RongmingGuo/ME4012_FinalProject/Deliverables/CartPicture.jpg

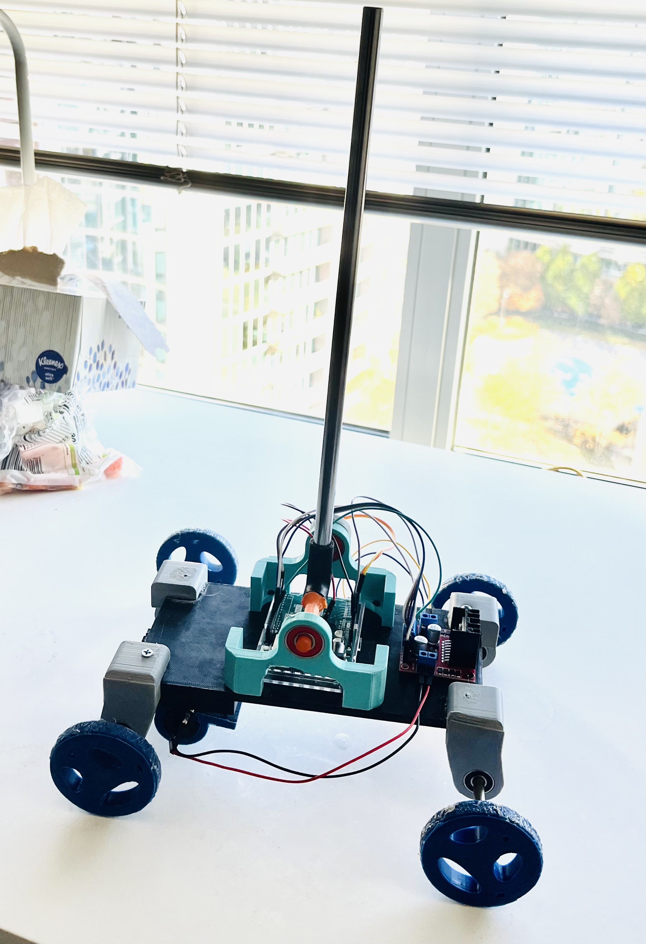
Deliverables/CartPicture.jpg
