RongmingGuo/ME4012_FinalProject/Theory/ME4012_FinalProject_Theory.docx

ME 4012 Final Project Theory Formulation

SECTION A. System Dynamics Modelling

Part 1. Cart Dynamics ( (Θ(s))/(Τ(s)) )

[Schematic]

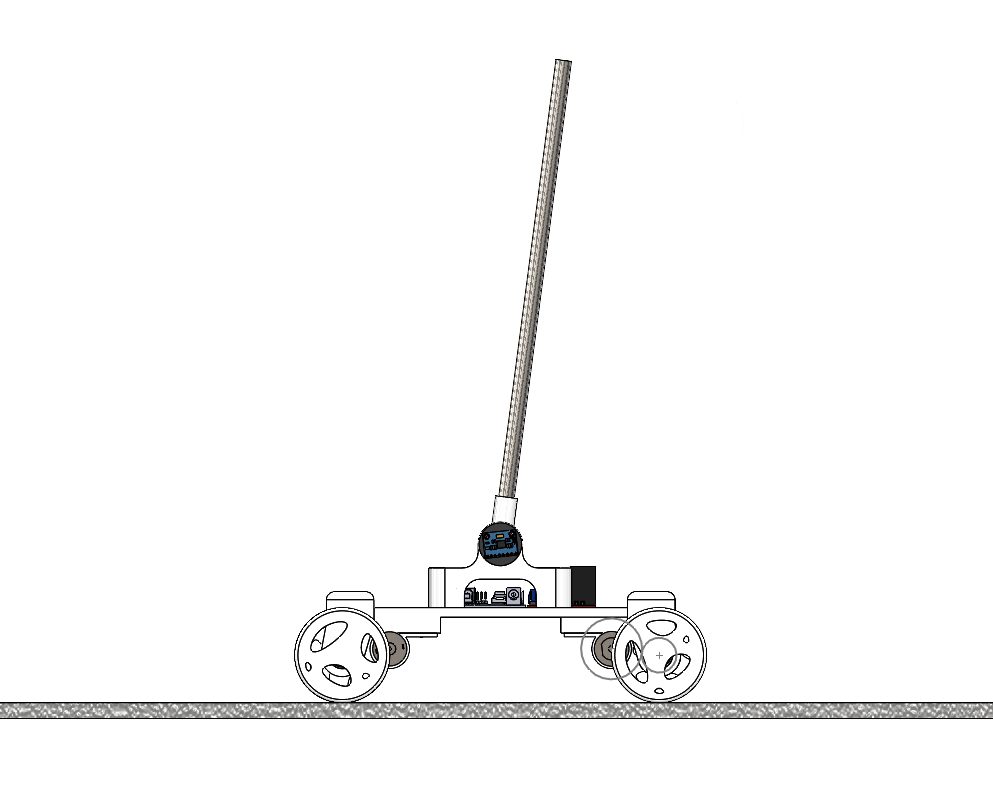
[picture p2: figure]

φ

+θ

+y

+x

τ

τ

θ

[Known]

1. World frame definition. Note that clockwise, rather than counterclockwise, is defined as the positive direction for angular quantities.
2. All relevant geometric & inertial quantities of the cart:

[Find]

The transfer function (Θ(s))/(Τ(s)) from wheel torque τ to the angular displacement of the inverted pendulum from its equilibrium position θ .

[Assumptions]

1. The cart body, excluding the pendulum, is perfectly symmetrical front-to-back and left-to-right.
2. The input torques at four wheels are of identical value at all times.
3. The torque will never break the traction of the tire (non-slip condition at the wheels).

[Analysis]

Free Body Diagram of the Cart Body (Excluding the Pendulum) in the x direction:

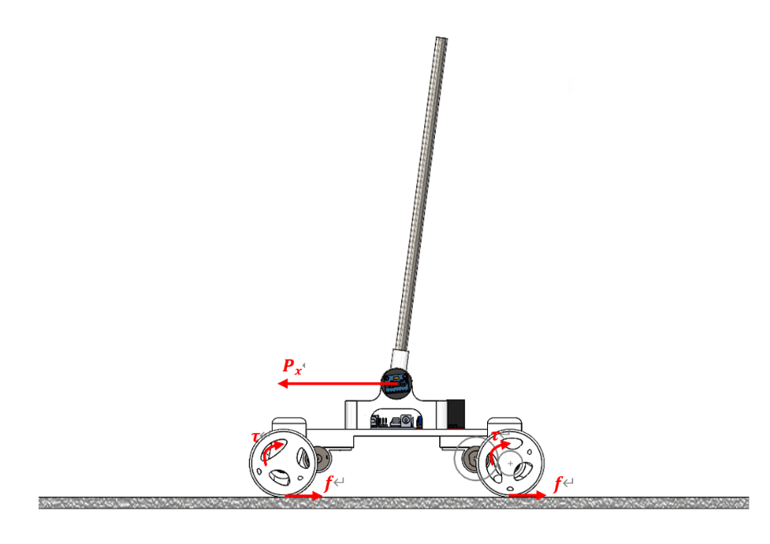
[picture p3: figure]

Dynamics at the wheel:

I_w φ= τ-fR…(1)

Dynamics of the cart body:

Mx=4f-P_x …(2)

Kinematics Constraint:

x=Rφ…(3)

Free Body Diagram of the Pendulum:

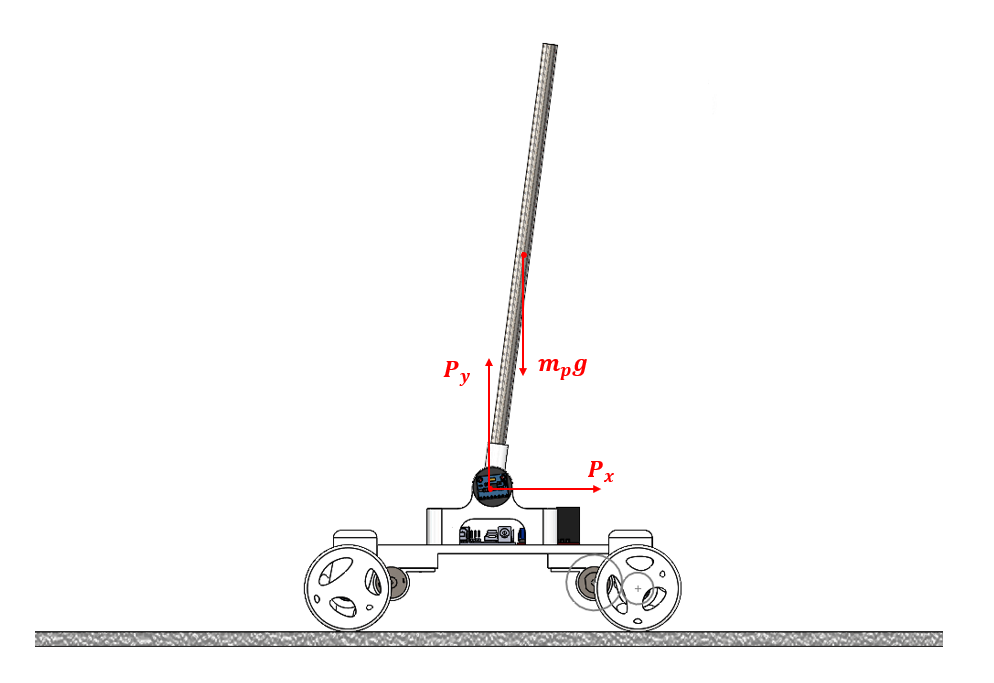
[picture p4: figure]

Linear Dynamics of the Pendulum:

m_p x_p =P_x …(4)

m_p y_p = -m_p g+P_y …(5)

Angular Dynamics of the Pendulum:

I_p θ=P_y (L*sinθ))-P_x (L*cos⁡θ)…(6)

Kinematics Constraint:

x_p =x+L*sinθ…(7)

y_p =L*cosθ…(8)

Take second order derivative of equation (7) and (8) to transform kinematics relationship at displacement level to acceleration level:

x_p =x+L*cosθθ

y_p =-L*sinθθ

(First Order)

x_p =x+L*(-sinθθ^2 +cosθθ)…(9)

y_p =-L*(cosθθ^2 +sinθθ)…(10)

(Second Order)

From equation (1) and (3), we have

MRφ=4f-P_x

Multiply both sides by 1/4R :

1/4MR^2 φ=fR-1/4(RP_x )

Add the above equation with (2) to eliminate friction term:

(1/4MR^2 +I_w )φ= τ-1/4(RP_x )

From equation (3), (4) and (9), we can represent P_x using a bunch of accelerations:

P_x =m_p [Rφ+L*(-sinθθ^2 +cosθθ)]…(11)

Therefore, the first equation of motion relating input torque τ to the two kinematics variables θ and φ can be obtained

(1/4MR^2 +I_w )φ= τ-R/4[m_p [Rφ+L*(-sinθθ^2 +cosθθ)]]…EOM_1

Combine equation (5) and (10), we can represent P_y with a bunch of accelerations:

P_y =m_p (-L*(cosθθ^2 +sinθθ))+m_p g…(12)

Plug equation (11) and (12) into equation (6), we can obtain the second equation of motion relating the two kinematics variables θ and φ .

I_p θ=[m_p (-L*(cosθθ^2 +sinθθ))+m_p g](L*sinθ)-m_p [Rφ+L*(-sinθθ^2 +cosθθ)](L*cosθ)…EOM_2

Using the above two equations of motion, MATLAB is able to solve for the exact solutions of the dynamics when provided with initial conditions and control torque. The “nonlinear_simulation.m” file utilizes this approach and creates a simulation environment for testing and tuning our controllers.

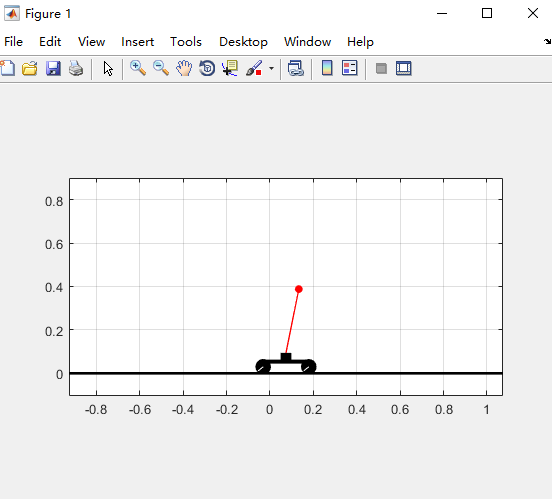
[picture p5: figure]
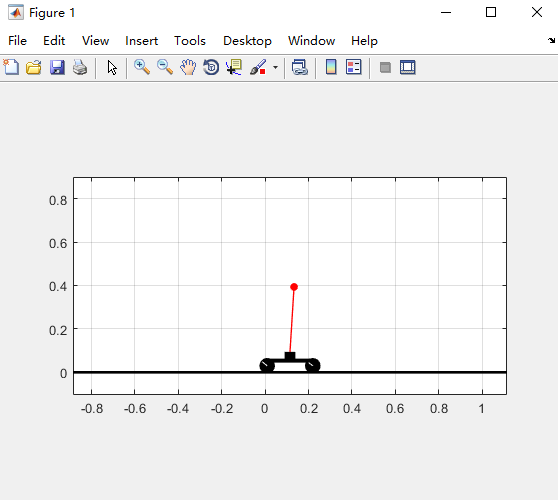
[picture p6: figure]
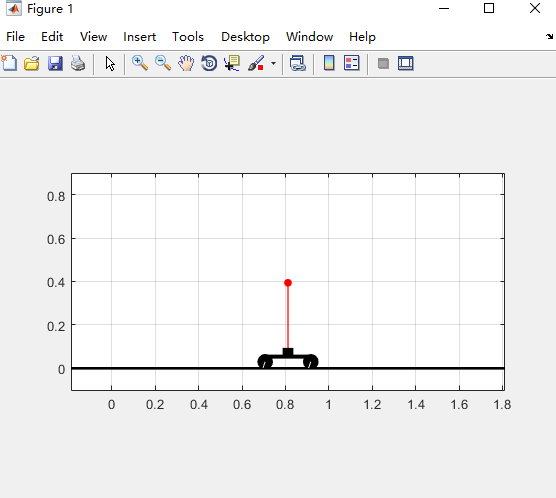
[picture p7: figure]

t = 0.03s t = 0.08s t = 0.5s

To obtain transfer function, however, the system needs to be linearized. Linearize around the operating point

θ_0 =0

Linearizing EOM1:

(1/4MR^2 +I_w )φ= τ-R/4[m_p [Rφ+L*(-sinθθ^2 +cosθθ)]]…EOM_1

First, reorganize terms:

(1/4MR^2 +I_w +(m_p R^2)/4)φ+(m_p RL)/4(-sinθθ^2 +cosθθ)= τ

Linearize using the following approximations:

sinθ≈∆θ cosθ≈1 θ^2 ≈(0)^2 +(0)(∆θ)=0

(1/4MR^2 +I_w +(m_p R^2)/4)φ+(m_p RL)/4θ= τ…Linearized EOM1

Linearize EOM2 using the same approximations:

I_p θ=[m_p (-L*(cosθθ^2 +sinθθ))+m_p g](L*sinθ)-m_p [Rφ+L*(-sinθθ^2 +cosθθ)](L*cosθ)

I_p θ=m_p g(Lθ)-m_p L(Rφ+Lθ)

Reorganize terms:

(I_p +m_p L^2 )θ-m_p gLθ=m_p LRφ…EOM2

Take Laplace transform on both linearized equations:

(1/4MR^2 +I_w +(m_p R^2)/4)s^2 Φ(s)+(m_p RL)/4s^2 Θ(s)= Τ(s)…(13)

(I_p +m_p L^2 )s^2 Θ(s)-(m_p gL)Θ(s)=(m_p LRs^2 )Φ(s)…(14)

Plug (14) back into (13) yields the ultimate transfer function (Θ(s))/(Τ(s)) :

(I_w +((M+m_p )R^2)/4)s^2 (((I_p +m_p L^2 )s^2 - (m_p gL))/((m_p LRs^2 )))Θ(s)+ (m_p RL)/4s^2 Θ(s)= Τ(s)

(Θ(s))/(Τ(s))=1/([(I_w +((M+m_p )R^2)/4)((I_p +m_p L^2)/((m_p LR))+((m_p RL)/4)]s^2 -((I_w +((M+m_p )R^2)/4)g)/R)

Overall, the system appears to be second order with zero damping, which agrees with our intuition since zero-friction condition was assumed.

Comparing the step response of the linearized system with that of the original nonlinear system:

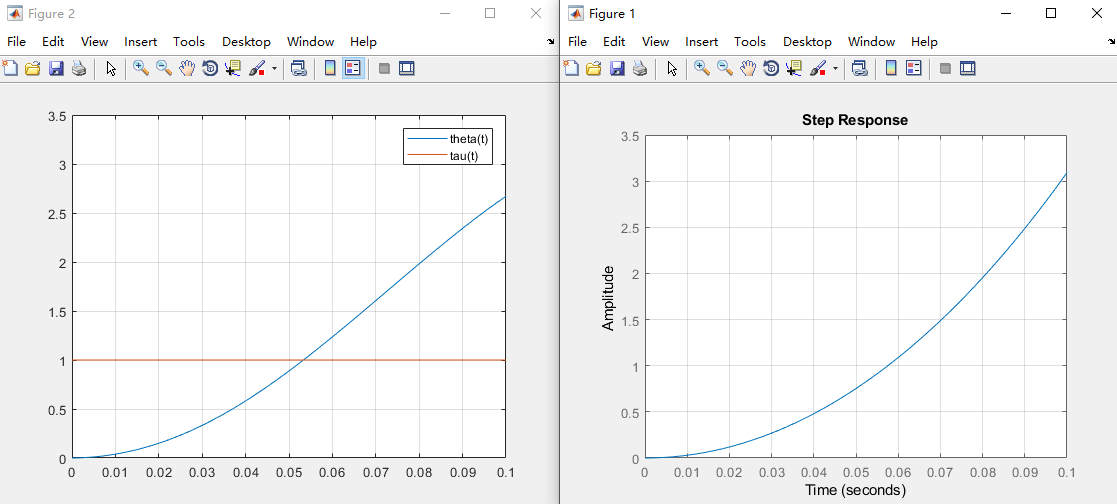
[picture p8: figure]

The result is pretty satisfactory.
