RongmingGuo/ME4012_FinalProject/References.docx

https://mschoeffler.com/2017/10/05/tutorial-how-to-use-the-gy-521-module-mpu-6050-breakout-board-with-the-arduino-uno/
