RongmingGuo/ME4012_FinalProject/ME4012_finalProject_Official_Nov2/ME4012_finalProject_Official/CAD Design/SegwayCar2.JPG

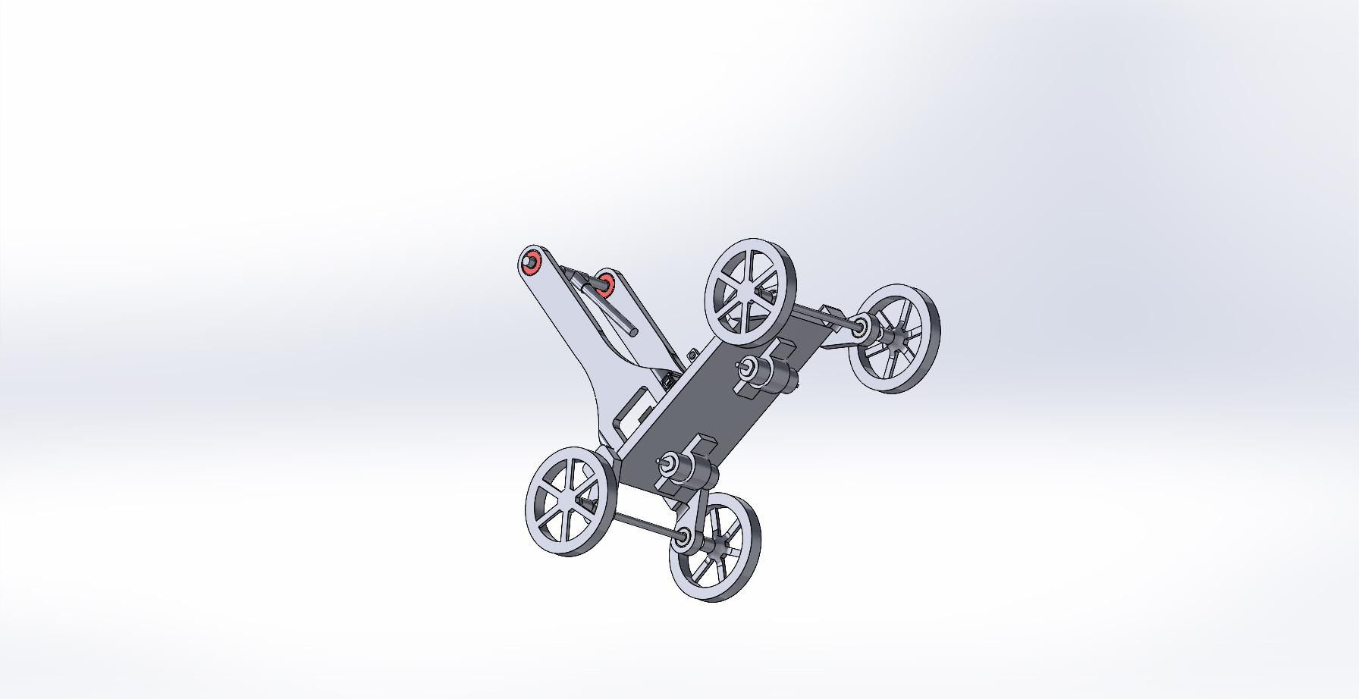
ME4012_finalProject_Official_Nov2/ME4012_finalProject_Official/CAD Design/SegwayCar2.JPG
