RongmingGuo/ME4012_FinalProject/partPurchase.xlsx

Date | Part | Website | Cost
2022-10-20 | 8mm Ball Bearings | https://www.amazon.com/gp/product/B07S1B3MS6/ref=ppx_yo_dt_b_asin_title_o00_s00?ie=UTF8&psc=1 | 17.94$
2022-10-20 | 6mm Ball Bearings | https://www.amazon.com/gp/product/B07FF6FSK7/ref=ppx_yo_dt_b_asin_title_o00_s00?ie=UTF8&psc=1
