RongmingGuo/ME4012_FinalProject/Manufacture4/mainBoard.STL

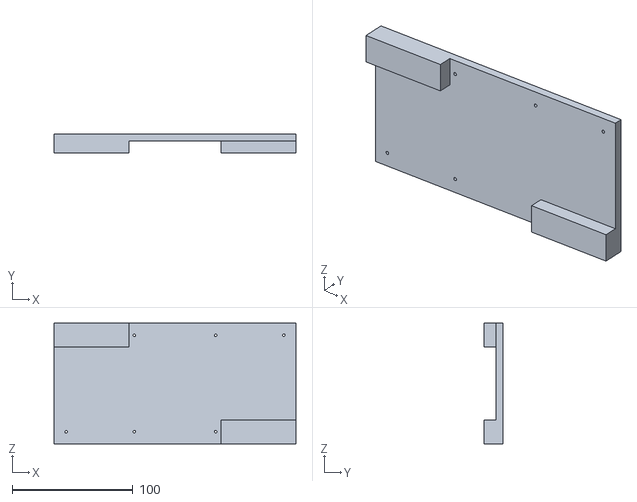
[picture p13: CAD file, 2022-11-29]
Manufacture4/mainBoard.STL
200.0 x 16.0 x 100.0
