RongmingGuo/ME4012_FinalProject/CAD_Design/CAD Design/Mechatronic Components/DC Motor.SLDPRT

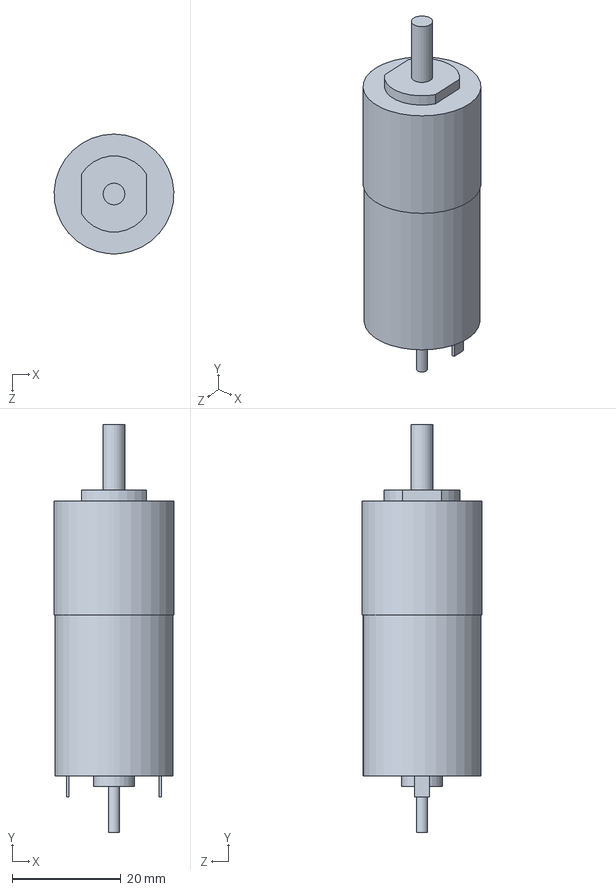
[picture p14: CAD file, 2022-10-30]
CAD_Design/CAD Design/Mechatronic Components/DC Motor.SLDPRT
22.0 x 74.9 x 22.0 mm
