RongmingGuo/ME4012_FinalProject/ME4012_finalProject_Official_Nov2/ME4012_finalProject_Official/CAD Design/CAD Design/motorMount.SLDPRT

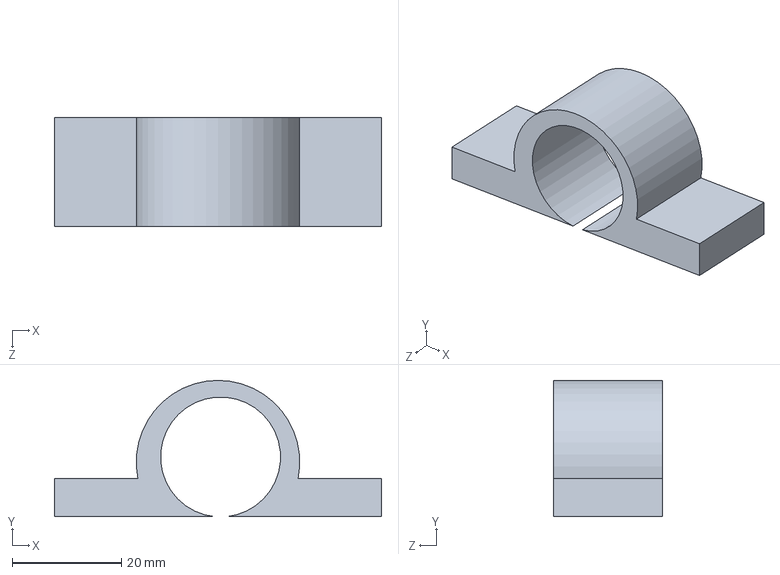
[picture p15: CAD file, 2022-10-30]
ME4012_finalProject_Official_Nov2/ME4012_finalProject_Official/CAD Design/CAD Design/motorMount.SLDPRT
60.0 x 25.0 x 20.0 mm
