RongmingGuo/ME4012_FinalProject/ME4012_finalProject_Official_Nov2/ME4012_finalProject_Official/CAD Design/Mechatronic Components/flange.SLDPRT

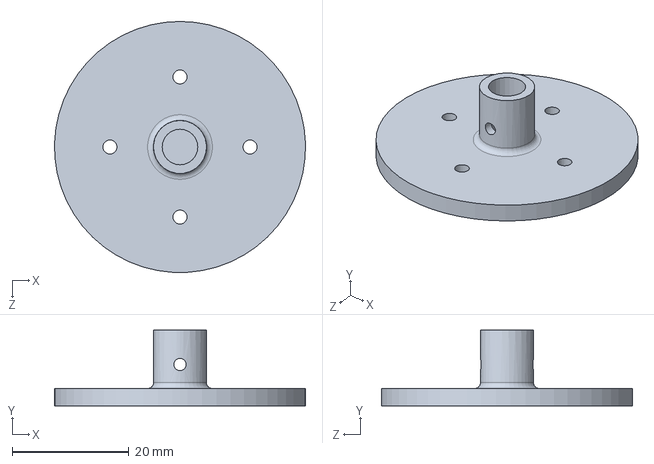
[picture p16: CAD file, 2022-11-29]
ME4012_finalProject_Official_Nov2/ME4012_finalProject_Official/CAD Design/Mechatronic Components/flange.SLDPRT
43.0 x 13.0 x 43.0 mm
