RongmingGuo/ME4012_FinalProject/ME4012_finalProject_Official_Nov2/ME4012_finalProject_Official/Manufacture1/Pole_version2.STL

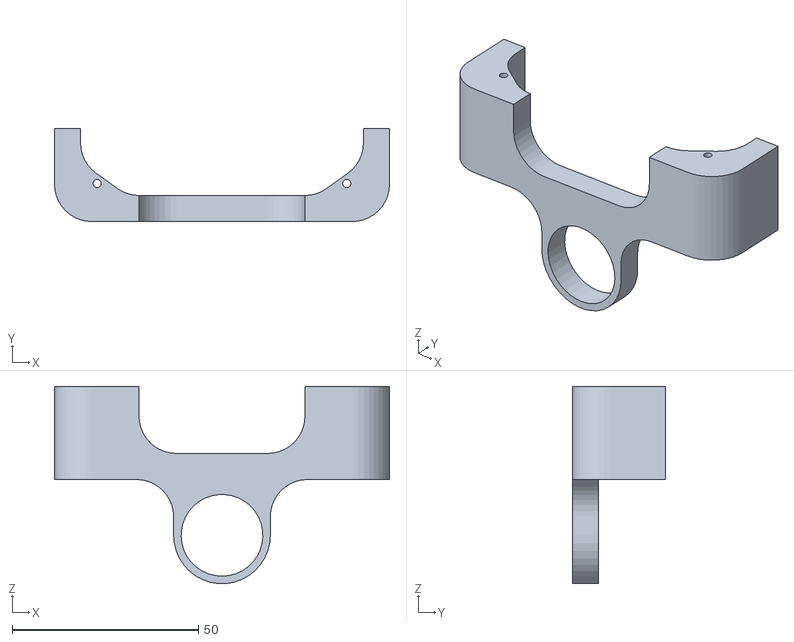
[picture p18: CAD file, 2022-10-30]
ME4012_finalProject_Official_Nov2/ME4012_finalProject_Official/Manufacture1/Pole_version2.STL
90.0 x 25.0 x 53.0
