RongmingGuo/ME4012_FinalProject/ME4012_finalProject_Official_Nov2/ME4012_finalProject_Official/Manufacture2/6mmShaft.STL

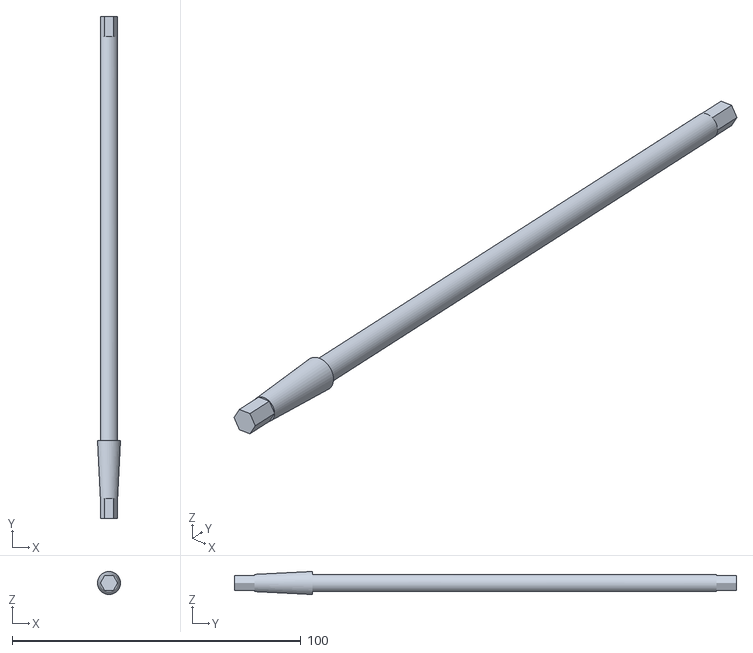
[picture p19: CAD file, 2022-11-29]
ME4012_finalProject_Official_Nov2/ME4012_finalProject_Official/Manufacture2/6mmShaft.STL
7.99 x 174.0 x 8.00
