RongmingGuo/ME4012_FinalProject/ME4012_finalProject_Official_Nov2/ME4012_finalProject_Official/Manufacture3/centralShaftsecurer.STL

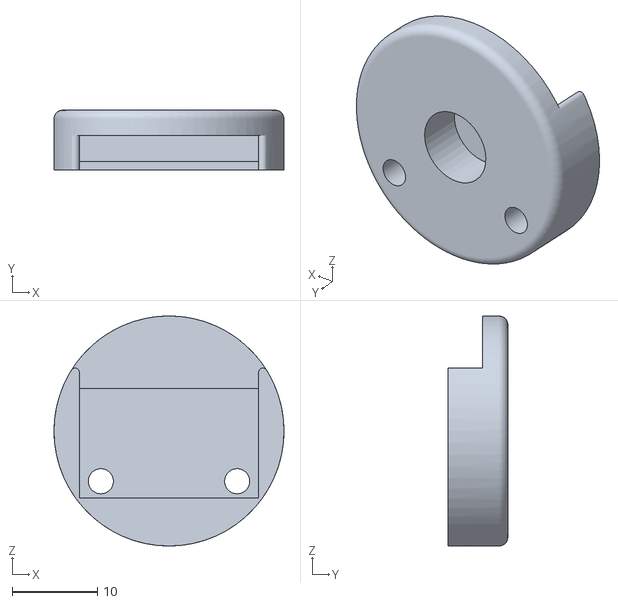
[picture p20: CAD file, 2022-11-29]
ME4012_finalProject_Official_Nov2/ME4012_finalProject_Official/Manufacture3/centralShaftsecurer.STL
27.0 x 7.00 x 27.0
