RongmingGuo/ME4012_FinalProject/ME4012_finalProject_Official_Nov2/ME4012_finalProject_Official/Manufacture4/flange.STL

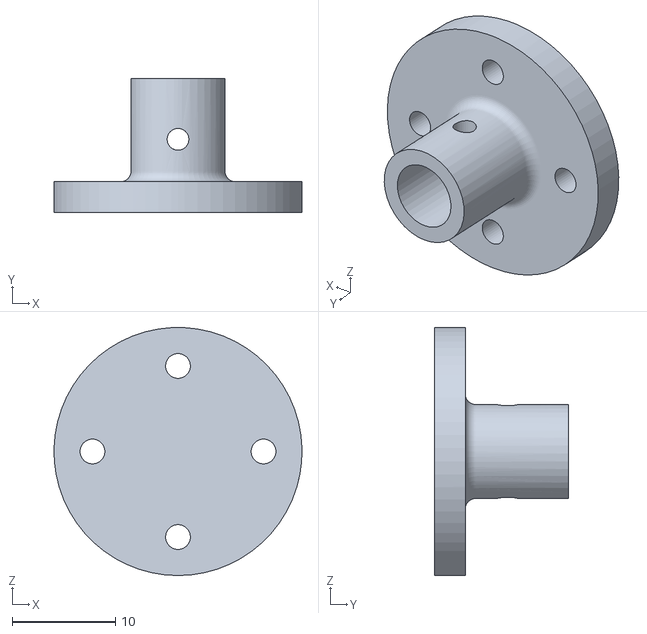
[picture p21: CAD file, 2022-11-29]
ME4012_finalProject_Official_Nov2/ME4012_finalProject_Official/Manufacture4/flange.STL
24.0 x 13.0 x 24.0
