RongmingGuo/ME4012_FinalProject/Manufacture4/BIG_GEAR2.SLDPRT

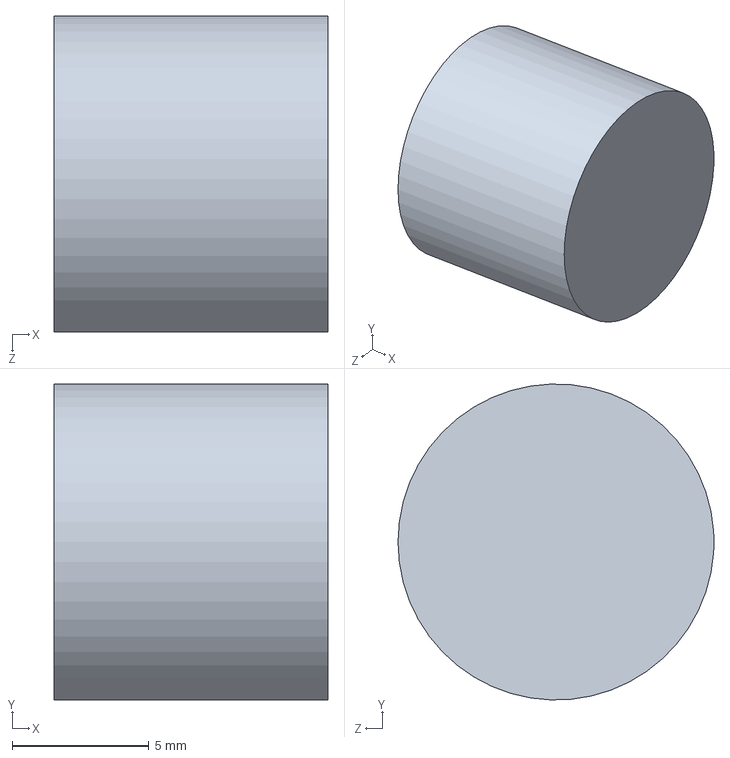
[picture p22: CAD file, 2022-11-29]
Manufacture4/BIG_GEAR2.SLDPRT
10.0 x 11.5 x 11.5 mm
