RongmingGuo/ME4012_FinalProject/ME4012_finalProject_Official_Nov2/ME4012_finalProject_Official/CAD Design/CAD Design/Mechatronic Components/MPU_6050.SLDPRT

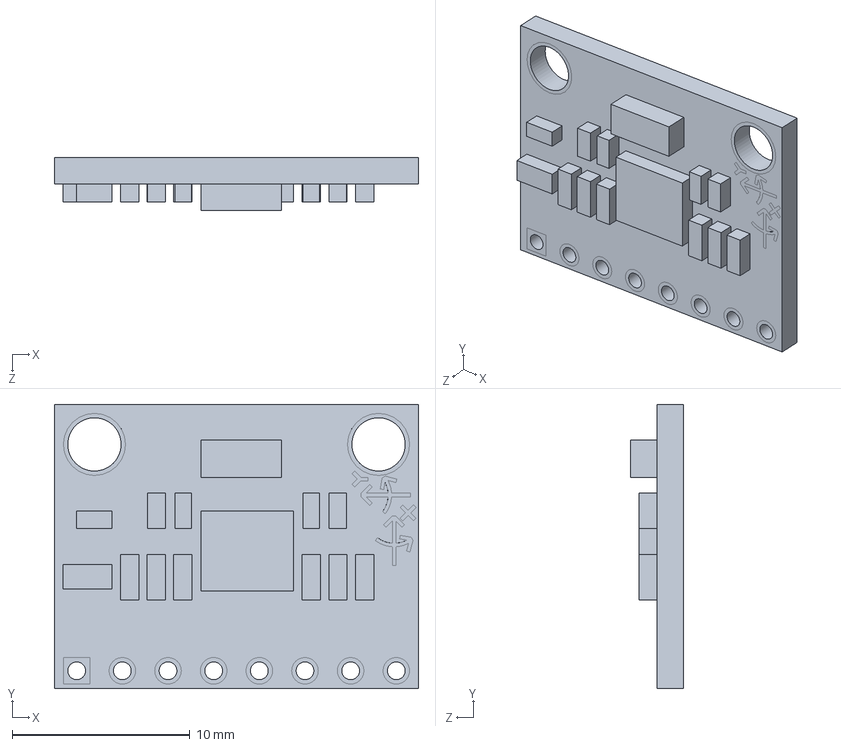
[picture p23: CAD file, 2022-10-30]
ME4012_finalProject_Official_Nov2/ME4012_finalProject_Official/CAD Design/CAD Design/Mechatronic Components/MPU_6050.SLDPRT
20.5 x 16.0 x 3.00 mm
