RongmingGuo/ME4012_FinalProject/ME4012_finalProject_Official_Nov2/ME4012_finalProject_Official/CAD Design/Mechatronic Components/DC Motor.SLDPRT

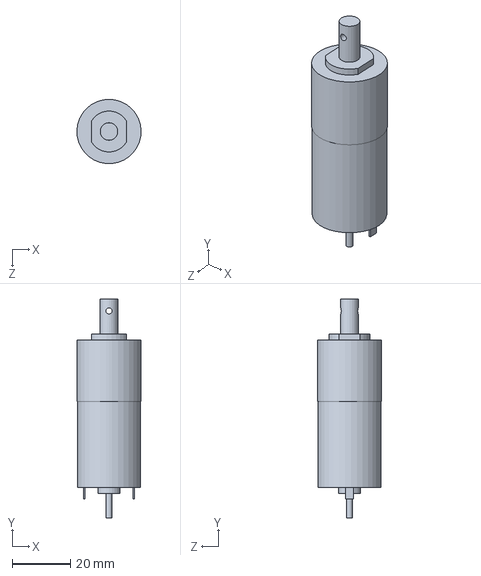
[picture p24: CAD file, 2022-11-29]
ME4012_finalProject_Official_Nov2/ME4012_finalProject_Official/CAD Design/Mechatronic Components/DC Motor.SLDPRT
22.0 x 74.9 x 22.0 mm
