RongmingGuo/ME4012_FinalProject/ME4012_finalProject_Official_Nov2/ME4012_finalProject_Official/CAD Design/Pole_version2.SLDPRT

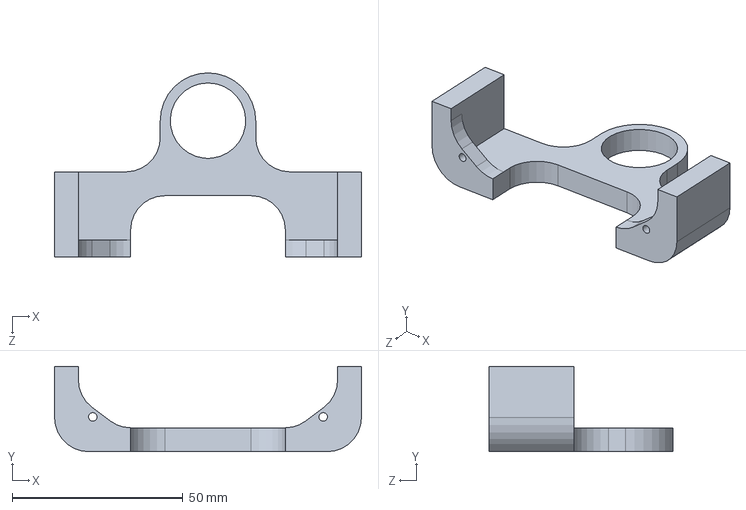
[picture p25: CAD file, 2022-11-29]
ME4012_finalProject_Official_Nov2/ME4012_finalProject_Official/CAD Design/Pole_version2.SLDPRT
90.0 x 25.0 x 54.0 mm
