RongmingGuo/ME4012_FinalProject/ME4012_finalProject_Official_Nov2/ME4012_finalProject_Official/Manufacture1/connector.STL

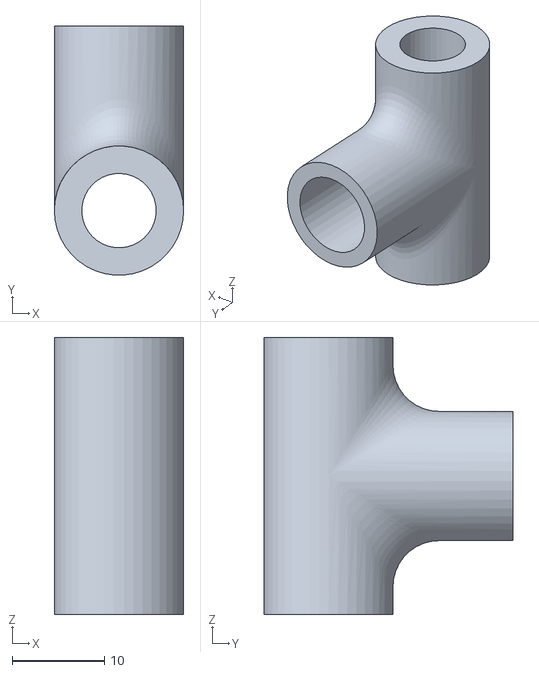
[picture p26: CAD file, 2022-10-30]
ME4012_finalProject_Official_Nov2/ME4012_finalProject_Official/Manufacture1/connector.STL
14.0 x 27.0 x 30.0
