RongmingGuo/ME4012_FinalProject/ME4012_finalProject_Official_Nov2/ME4012_finalProject_Official/Manufacture2/wheelAttacher.STL

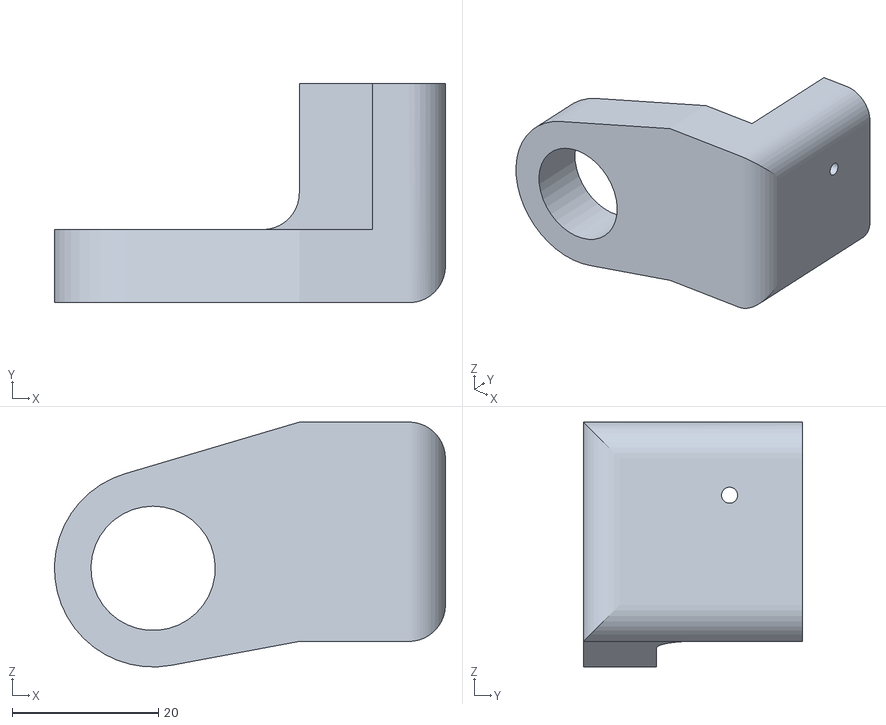
[picture p27: CAD file, 2022-11-29]
ME4012_finalProject_Official_Nov2/ME4012_finalProject_Official/Manufacture2/wheelAttacher.STL
53.5 x 30.0 x 33.5
