RongmingGuo/ME4012_FinalProject/Manufacture4/SMALL_GEAR.STL

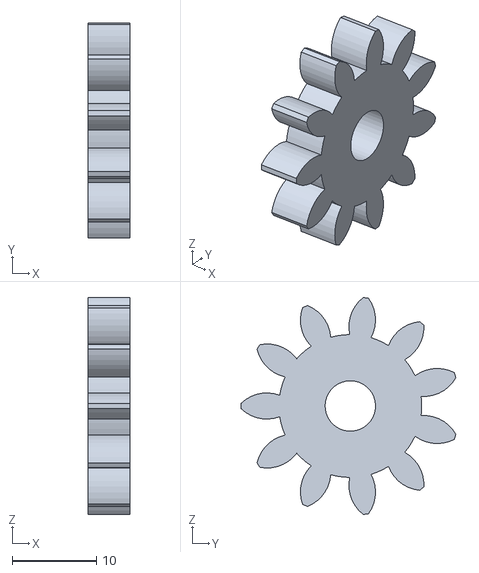
[picture p28: CAD file, 2022-11-29]
Manufacture4/SMALL_GEAR.STL
5.00 x 25.6 x 25.8
