RongmingGuo/ME4012_FinalProject/ME4012_finalProject_Official_Nov2/ME4012_finalProject_Official/CAD Design/Mechatronic Components/BallBearing.SLDPRT

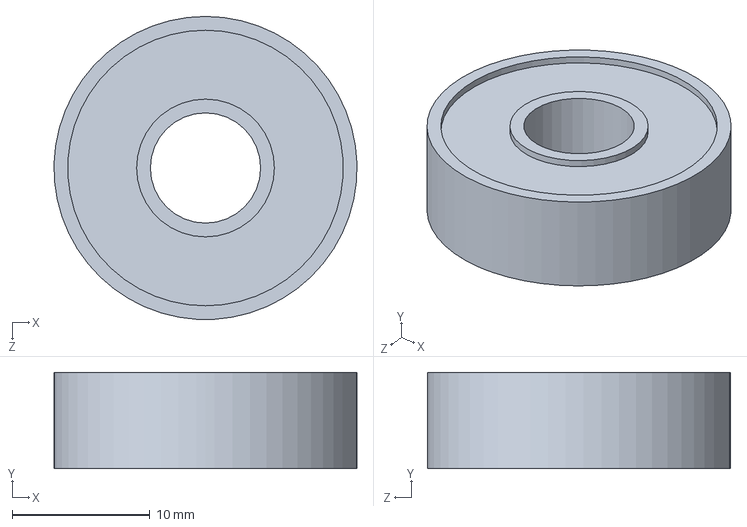
[picture p29: CAD file, 2022-10-30]
ME4012_finalProject_Official_Nov2/ME4012_finalProject_Official/CAD Design/Mechatronic Components/BallBearing.SLDPRT
22.0 x 7.00 x 22.0 mm
