RongmingGuo/ME4012_FinalProject/ME4012_finalProject_Official_Nov2/ME4012_finalProject_Official/CAD Design/motorMount.SLDPRT

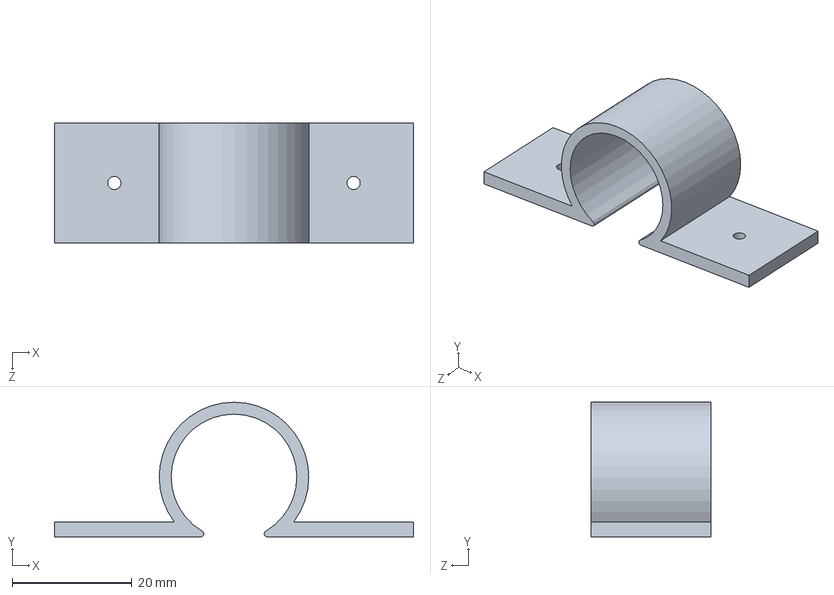
[picture p30: CAD file, 2022-11-29]
ME4012_finalProject_Official_Nov2/ME4012_finalProject_Official/CAD Design/motorMount.SLDPRT
60.0 x 22.5 x 20.0 mm
