RongmingGuo/ME4012_FinalProject/ME4012_finalProject_Official_Nov2/ME4012_finalProject_Official/Manufacture1/motorMount.STL

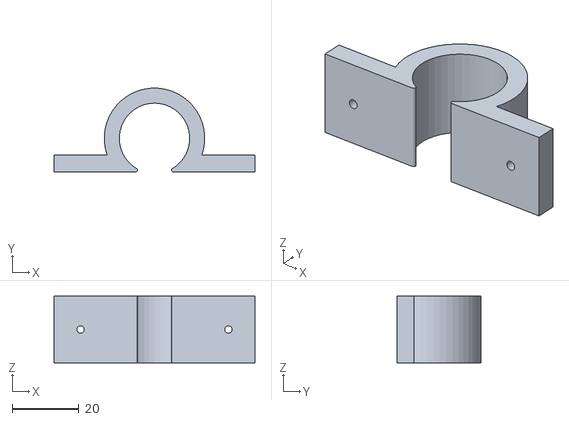
[picture p31: CAD file, 2022-10-30]
ME4012_finalProject_Official_Nov2/ME4012_finalProject_Official/Manufacture1/motorMount.STL
60.0 x 25.0 x 20.0
