RongmingGuo/ME4012_FinalProject/ME4012_finalProject_Official_Nov2/ME4012_finalProject_Official/CAD Design/Mechatronic Components/L298N Motor Driver.SLDPRT

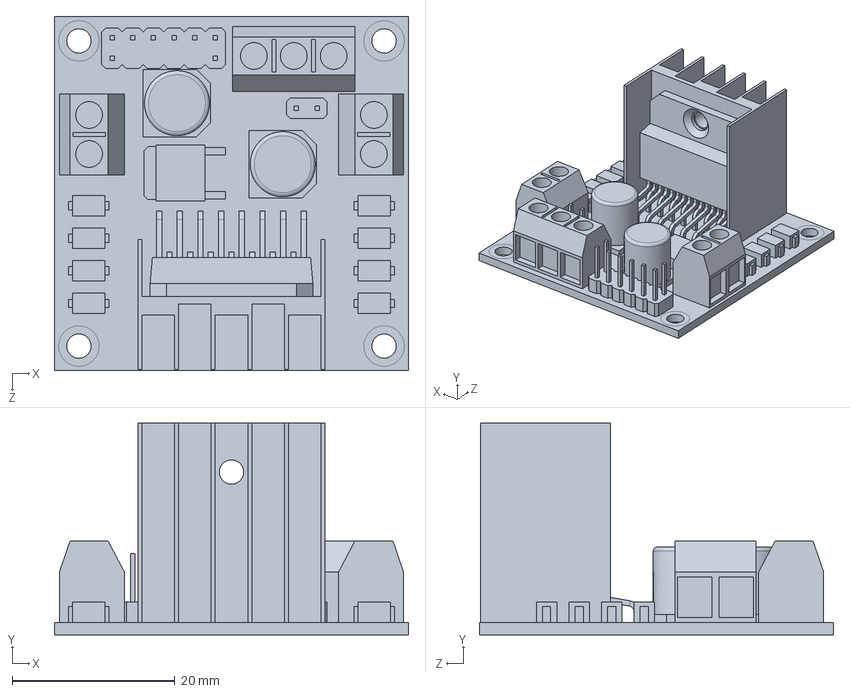
[picture p32: CAD file, 2022-10-30]
ME4012_finalProject_Official_Nov2/ME4012_finalProject_Official/CAD Design/Mechatronic Components/L298N Motor Driver.SLDPRT
43.5 x 26.0 x 43.5 mm
