RongmingGuo/ME4012_FinalProject/ME4012_finalProject_Official_Nov2/ME4012_finalProject_Official/Manufacture1/pendulumshaft.STL

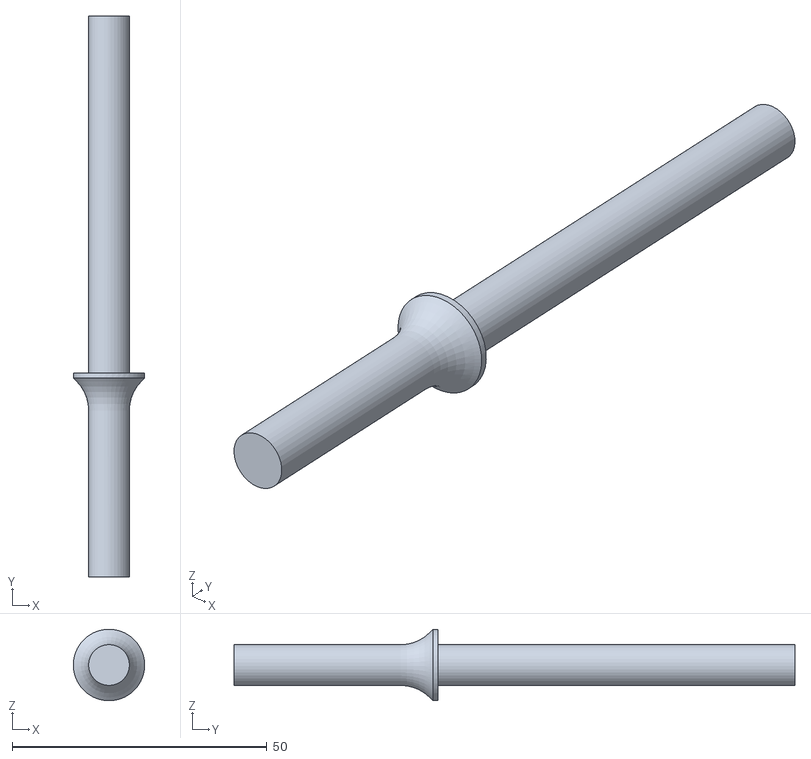
[picture p33: CAD file, 2022-10-30]
ME4012_finalProject_Official_Nov2/ME4012_finalProject_Official/Manufacture1/pendulumshaft.STL
14.0 x 110.0 x 14.0
