RongmingGuo/ME4012_FinalProject/ME4012_finalProject_Official_Nov2/ME4012_finalProject_Official/Manufacture1/centralShaftsecurer.STL

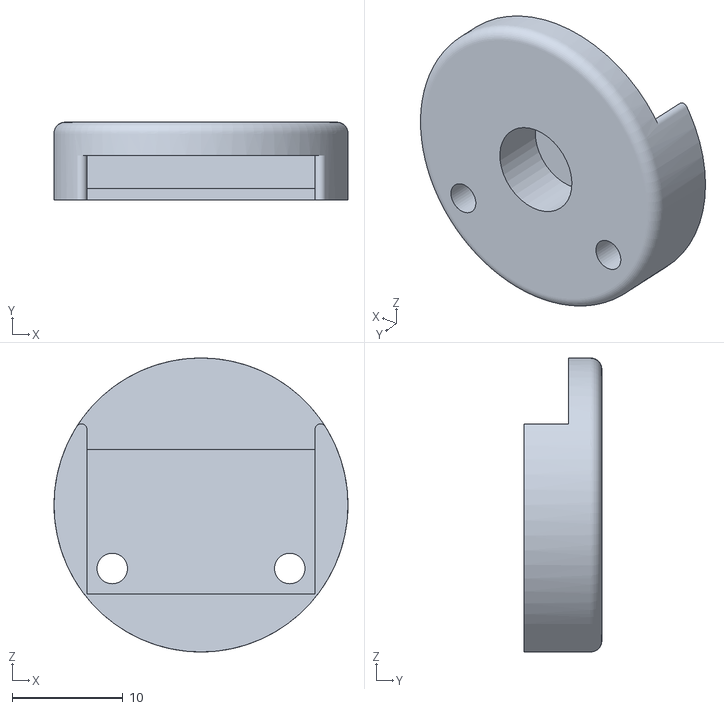
[picture p35: CAD file, 2022-10-30]
ME4012_finalProject_Official_Nov2/ME4012_finalProject_Official/Manufacture1/centralShaftsecurer.STL
26.5 x 7.00 x 26.5
