RongmingGuo/ME4012_FinalProject/ME4012_finalProject_Official_Nov2/ME4012_finalProject_Official/CAD Design/BIG_GEAR.SLDPRT

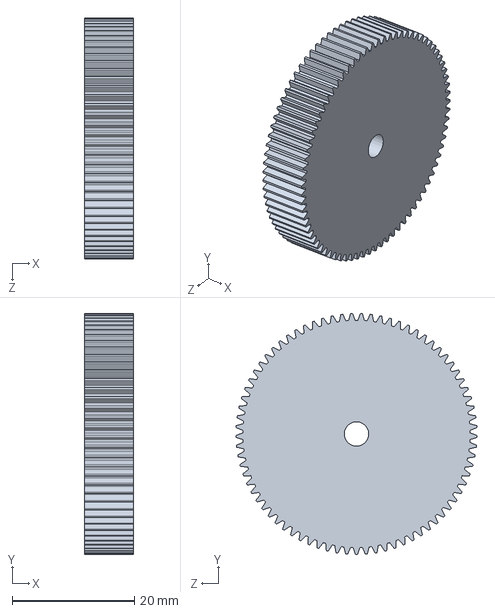
[picture p37: CAD file, 2022-11-29]
ME4012_finalProject_Official_Nov2/ME4012_finalProject_Official/CAD Design/BIG_GEAR.SLDPRT
8.00 x 39.5 x 39.5 mm
