RongmingGuo/ME4012_FinalProject/ME4012_finalProject_Official_Nov2/ME4012_finalProject_Official/Manufacture3/6mmShaft.STL

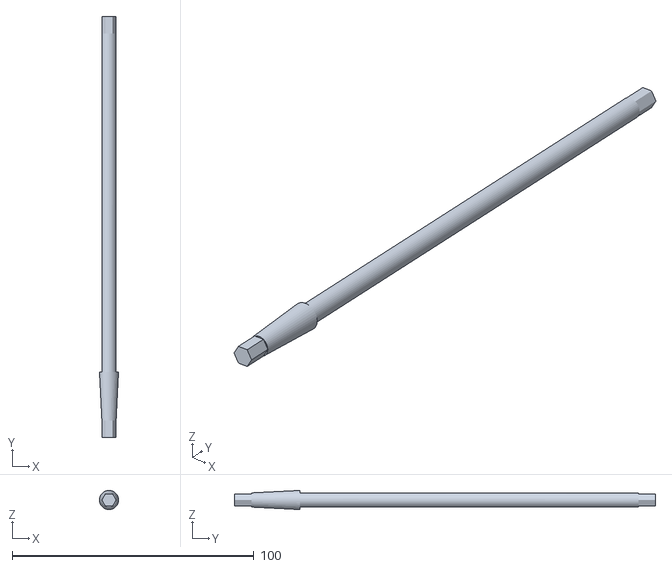
[picture p38: CAD file, 2022-11-29]
ME4012_finalProject_Official_Nov2/ME4012_finalProject_Official/Manufacture3/6mmShaft.STL
7.89 x 174.0 x 7.90
