RongmingGuo/ME4012_FinalProject/ME4012_finalProject_Official_Nov2/ME4012_finalProject_Official/CAD Design/SMALL_GEAR.SLDPRT

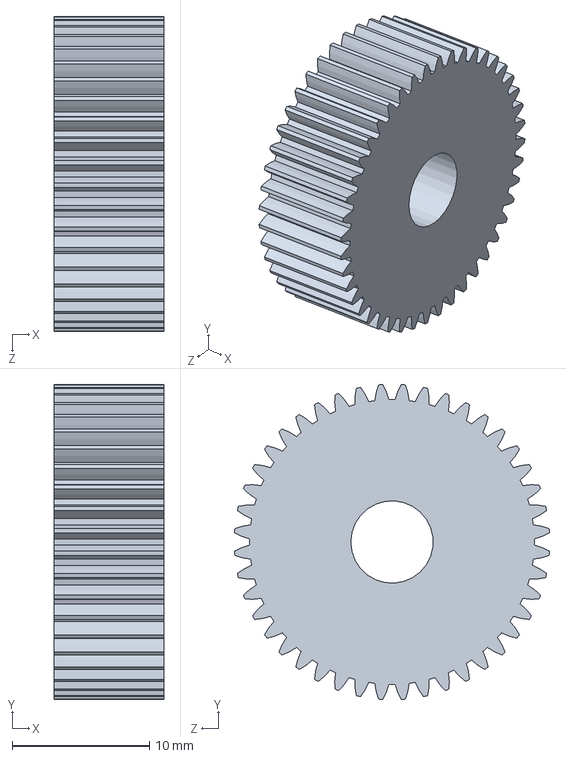
[picture p39: CAD file, 2022-11-29]
ME4012_finalProject_Official_Nov2/ME4012_finalProject_Official/CAD Design/SMALL_GEAR.SLDPRT
8.00 x 23.0 x 23.0 mm
