RongmingGuo/ME4012_FinalProject/ME4012_finalProject_Official_Nov2/ME4012_finalProject_Official/CAD Design/pendulumRod.SLDPRT

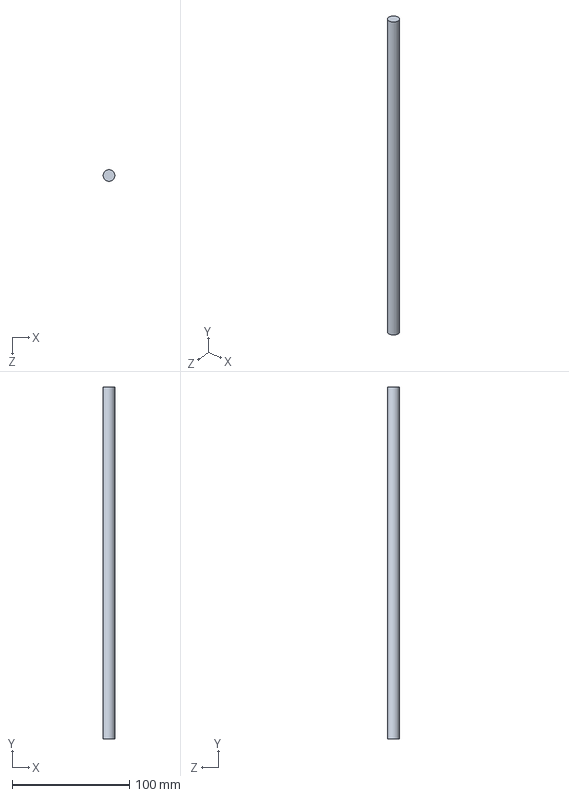
[picture p41: CAD file, 2022-10-30]
ME4012_finalProject_Official_Nov2/ME4012_finalProject_Official/CAD Design/pendulumRod.SLDPRT
10.0 x 300.0 x 10.0 mm
