RongmingGuo/ME4012_FinalProject/ME4012_finalProject_Official_Nov2/ME4012_finalProject_Official/CAD Design/pendulum.SLDPRT

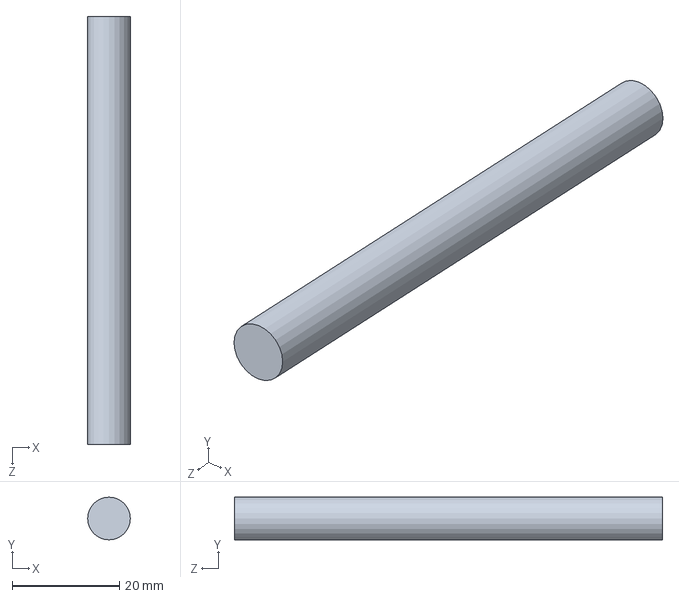
[picture p42: CAD file, 2022-10-30]
ME4012_finalProject_Official_Nov2/ME4012_finalProject_Official/CAD Design/pendulum.SLDPRT
8.00 x 8.00 x 80.0 mm
