RongmingGuo/ME4012_FinalProject/ME4012_finalProject_Official_Nov2/ME4012_finalProject_Official/CAD Design/BallBearing6mm.SLDPRT

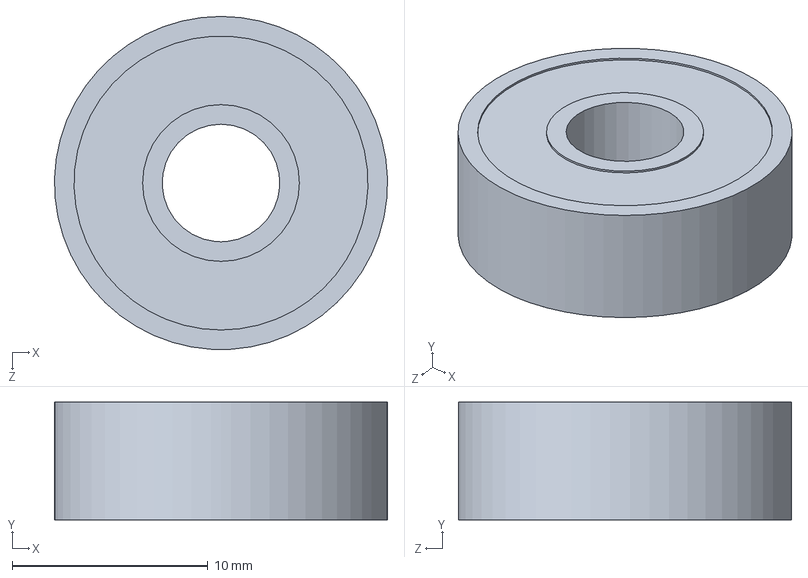
[picture p43: CAD file, 2022-10-30]
ME4012_finalProject_Official_Nov2/ME4012_finalProject_Official/CAD Design/BallBearing6mm.SLDPRT
17.0 x 6.00 x 17.0 mm
