RongmingGuo/ME4012_FinalProject/(list of files, cad)

Other CAD files:
ME4012_finalProject_Official_Nov2/ME4012_finalProject_Official/CAD Design/mainBoard.SLDPRT
ME4012_finalProject_Official_Nov2/ME4012_finalProject_Official/Manufacture3/mainBoard.STL
ME4012_finalProject_Official_Nov2/ME4012_finalProject_Official/CAD Design/CAD Design/Mechatronic Components/DC Motor.SLDPRT
ME4012_finalProject_Official_Nov2/ME4012_finalProject_Official/Manufacture3/Pole_version2.STL
ME4012_finalProject_Official_Nov2/ME4012_finalProject_Official/Manufacture2/wheelAttacher2.STL
ME4012_finalProject_Official_Nov2/ME4012_finalProject_Official/Manufacture3/wheelAttacher2.STL
Manufacture4/BIG_GEAR.SLDPRT
ME4012_finalProject_Official_Nov2/ME4012_finalProject_Official/CAD Design/wheelAttacher2.SLDPRT
ME4012_finalProject_Official_Nov2/ME4012_finalProject_Official/CAD Design/onnector.SLDPRT
ME4012_finalProject_Official_Nov2/ME4012_finalProject_Official/Manufacture3/wheelAttacher.STL
ME4012_finalProject_Official_Nov2/ME4012_finalProject_Official/Manufacture3/motorMount.STL
ME4012_finalProject_Official_Nov2/ME4012_finalProject_Official/CAD Design/wheel.SLDPRT
ME4012_finalProject_Official_Nov2/ME4012_finalProject_Official/CAD Design/centralShaftsecurer.SLDPRT
ME4012_finalProject_Official_Nov2/ME4012_finalProject_Official/CAD Design/shaft.SLDPRT
ME4012_finalProject_Official_Nov2/ME4012_finalProject_Official/CAD Design/6mmShaft.SLDPRT
CAD_Design/CAD Design/6mmShaft.SLDPRT
CAD_Design/CAD Design/Pole_version2.SLDPRT
CAD_Design/CAD Design/centralShaftsecurer.SLDPRT
CAD_Design/CAD Design/mainBoard.SLDPRT
CAD_Design/CAD Design/motorMount.SLDPRT
CAD_Design/CAD Design/onnector.SLDPRT
CAD_Design/CAD Design/shaft.SLDPRT
CAD_Design/CAD Design/wheel.SLDPRT
CAD_Design/CAD Design/wheelAttacher.SLDPRT
CAD_Design/CAD Design/wheelAttacher2.SLDPRT
ME4012_finalProject_Official_Nov2/ME4012_finalProject_Official/CAD Design/Pole.SLDPRT
Manufacture4/BIG_GEAR.STL
