RongmingGuo/ME4012_FinalProject/ME4012_finalProject_Official_Nov2/ME4012_finalProject_Official/Manufacture1/PrintingGuide.txt

centralShaftSecurer * 4
connector * 2
motorMount *3
pendulumShaft * 1
Pole_version2 * 3
