RongmingGuo/ME4012_FinalProject/ArduinoCode/MPU_SensorManual.docx

SDA: Sensor Data

Wiring MPU 6050 to Arduino: Arduino Uno, Arduino Ethernet, Arduino Nano: A4 (SDA), A5 (SCL)
