RongmingGuo/ME4012_FinalProject/ME 4012 Todo.docx

ME 4012 To-do (Constantly Updating)

- Integrate MPU-6050 Gyro onto the pendulum arm design
- Complete the drivetrain design – the wheels, the shaft, etc.
- Finalize bolt size range for the design, purchasing nuts / bolts kit (nuts and bolts for Arduino and sensor holes)
