RongmingGuo/ME4012_FinalProject/(commit log)

2022-10-23 initialize git repo from local folder
    [partPurchase.xlsx]
2022-10-23 updated the brute force simulation framework
2022-10-30 updated Solidworks file
    [6mmShaft.SLDPRT, BallBearing.SLDPRT, BallBearing6mm.SLDPRT, DC Motor.SLDPRT, L298N Motor Driver.SLDPRT, MPU_6050.SLDPRT, Pole.SLDPRT, Pole_version2.SLDPRT]
2022-11-10 initialized Arduino code folder. Incorporated MPU 6050 Gyro sensor into the main control code
2022-11-19 updated motor controller code
2022-11-29 updated cart parameters. Still need cart mass to be measured
    [6mmShaft.SLDPRT, 6mmShaft.STL, BIG_GEAR.SLDPRT, BIG_GEAR.STL, BIG_GEAR2.SLDPRT, BallBearing.SLDPRT, BallBearing6mm.SLDPRT, DC Motor.SLDPRT]
2022-11-30 updated cart parameters. Added sensor noise and distrubance to simulation
